linzaixing/joystick-mouse/BOM.md

# Arcade Mouse —— 物料清单（BOM）

街机摇杆 → BLE 无线鼠标（ESP32）项目的**采购 + 组装**清单。
固件已完成编译、烧录并**实测可被电脑蓝牙发现、配对成功**（2026-10-19）。

- 主控实测型号：**ESP32-C3 Super Mini**（`ESP32-C3 (QFN32) rev v0.4`，4 MB 片内 flash，MAC `f0:9e:9e:ad:77:80`）
- 引脚表、接线细节、内部上拉说明见 [README.md](README.md) 与 `joystick_mouse/joystick_mouse.ino` 头部注释
- 参考价为国内电商**粗略区间**，仅供估算，不作采购依据

---

## 1. 核心电控（必需）

| # | 物料 | 规格 / 选型要点 | 数量 | 状态 | 参考价(元) | 备注 |
|---|---|---|---|---|---|---|
| 1 | ESP32-C3 Super Mini | 乐鑫原生 USB，4 MB flash，22.5×18 mm | 1 | ✅ 已有 | 8~15 | 本项目已实测型号；用 `CDCOnBoot=cdc` 编译 |
| 1b | （替代）ESP32-WROOM-32 DevKit | 经典 ESP32，需 USB 转串口（CH340/CP2102） | 1 | 备用 | 15~25 | 引脚用固件里「第一套表」，无需 `cdc` 参数 |
| 2 | USB-C 数据线 | **要能传数据**，不是只有充电功能的线 | 1 | 待确认 | 5~10 | 烧录 + 供电 + 串口调试都靠它 |
| 3 | 排针 / 排母 | 2.54 mm，单排 | 1 条 | 待购 | 1~3 | Super Mini **出厂不带焊好的排针**，需自己焊，或直接焊导线 |
| 4 | 电源开关（可选） | 微型拨动开关 SS12D00 | 1 | 可选 | 1~2 | 装电池时建议加 |

> ⚠️ `ESP32-S2`、`ESP32-P4` 没有 BLE，不能用。

## 2. 操作件（摇杆 / 按钮 / 滚轮）

| # | 物料 | 规格 / 选型要点 | 数量 | 状态 | 参考价(元) | 备注 |
|---|---|---|---|---|---|---|
| 5 | 街机摇杆 | **微动开关式**（4 个方向微动，数字通断），8 向；常见三和 JLF-TP-8YT 或国产宝联 | 1 | 待购 | 15~40 | ⚠️ **别买电位器式 / 霍尔式**，固件是数字消抖，模拟量读不了 |
| 6 | 街机按钮 | 卡扣式 Ø24 / Ø30（如 OBSF-30 规格），自复位 | 2 | 待购 | 3~10 / 个 | 分别做左键 / 右键 |
| 7 | 滚轮模块 | **优先从废旧 2.4G 无线鼠标上拆**（编码器 + 中键微动一体） | 1 | 待购/待拆 | 0（拆机） | 拆机最省事，还自带支架与滚轮皮带 |
| 7b | （替代）机械式旋转编码器 | EC11 系列，**要带中键**（5 脚：A / B / C + 2 个按键脚） | 1 | 可选 | 3~8 | 编码器本体不贵，但要自己做滚轮与支架 |
| 8 | 精确模式按钮（可选） | 12 mm / 16 mm 自复位按钮 | 1 | 可选 | 1~3 | 按住光标降速到 35%；做机械臂时会更好用 |

## 3. 结构件与外壳

| # | 物料 | 规格 / 选型要点 | 数量 | 状态 | 参考价(元) | 备注 |
|---|---|---|---|---|---|---|
| 9 | 面板 | 亚克力 / 木板 / PVC，厚 **3~5 mm** | 1 | 待购/自制 | 10~30 | 开孔：摇杆 Ø30、按钮 Ø24/Ø30、滚轮 Ø7 |
| 10 | 底板 | 同上材质 | 1 | 待购/自制 | — | 与面板用铜柱撑开固定 |
| 11 | 螺丝 / 铜柱 | M3、M4 套装 + 自攻螺丝 | 1 套 | 待购 | 10~20 | 摇杆背面 M4 固定；卡片式按钮用卡扣环 |
| 12 | 防滑垫 | 自粘硅胶垫 | 4 | 待购 | 3~8 | 贴底板四角 |
| 13 | 摇杆防尘罩 / 球头 | 可选装饰件 | 1 | 可选 | 5~15 | 手感与外观 |

## 4. 线材与耗材

| # | 物料 | 规格 / 选型要点 | 数量 | 状态 | 参考价(元) | 备注 |
|---|---|---|---|---|---|---|
| 14 | 杜邦线 | 母-母 20 cm，或母-公 | 40 pin | 待购 | 3~6 | 摇杆自带 5 pin 排线，其余可自己接 |
| 15 | 插簧端子 | **2.8 mm** 插簧 + 绝缘护套 | 若干 | 待购 | 5~10 | 按钮/摇杆微动是 2.8 mm 端子；也可直接焊 |
| 16 | 单芯细线 / 硅胶线 | AWG26~28，多色 | 1 卷 | 待购 | 5~10 | 所有开关的 GND 汇成一条主线 |
| 17 | 热缩管 / 尼龙扎带 / 热熔胶 | — | 各 1 | 待购 | ~10 | 走线固定、绝缘收尾 |

## 5. 工具（一次性投入，非消耗件）

| # | 工具 | 用途 | 状态 | 参考价(元) |
|---|---|---|---|---|
| 18 | 电烙铁 + 焊锡 + 助焊剂 | 焊排针、焊端子/导线 | 待确认 | 50~150 |
| 19 | 万用表 | **上电前量滚轮/摇杆信号脚静态电平，必须 ≤ 3.3 V** | 待确认 | 30~80 |
| 20 | 开孔器 / 钻头 | 面板开孔（Ø30 / Ø24 / Ø7） | 待确认 | 20~40 |
| 21 | 斜口钳 / 剥线钳 / 螺丝刀 | 装线装配 | 待确认 | 20~40 |
| 22 | 带蓝牙的电脑 | 配对 + 调试（Windows / macOS / Linux / Android / iOS 均可） | ✅ 已有 | — |

## 6. 可选：无线便携供电

不做便携就**直接用 USB-C 供电/充电**，最省事，下列全部可跳过。

| # | 物料 | 规格 / 选型要点 | 数量 | 参考价(元) | 备注 |
|---|---|---|---|---|---|
| 23 | 锂电池 | 3.7 V 锂聚合物 500~1000 mAh | 1 | 15~30 | — |
| 24 | 升压模块 | MT3608 或同类，3.7 V → 5 V | 1 | 5~10 | ⚠️ 电池**不能直接接 Super Mini 的 5V 脚**（3.7 V 低于 LDO 压差要求），必须升到 5 V 再进 5V |
| 25 | 充电板 | TP4056（带保护） | 1 | 3~8 | 也可换成「充电宝 + USB-C 线」，更简单但体积大 |
| 26 | 电池盒 / 电池固定座 | 与所选电池匹配 | 1 | 3~8 | 避免电池在盒内晃动 |

> C3 Super Mini 板载 3.3 V LDO 由 5V 输入供电；**不要把锂电池直接怼到 3V3 脚**（那是 LDO 输出端）。

---

## 7. 接线对照表（按固件当前引脚，可直接照接）

所有开关一律 **COM → GND，信号脚 → GPIO**，用芯片内部上拉，**免外接电阻**。

**方案 A：ESP32-C3 Super Mini**（已烧录的这套）

| 功能 | GPIO | 对应物料 |
|---|---|---|
| 摇杆 上 UP | 3 | #5 |
| 摇杆 下 DOWN | 4 | #5 |
| 摇杆 左 LEFT | 5 | #5 |
| 摇杆 右 RIGHT | 6 | #5 |
| 按钮 左键 | 7 | #6 |
| 按钮 右键 | 10 | #6 |
| 滚轮 编码器 A 相 | 20 | #7 / #7b |
| 滚轮 编码器 B 相 | 21 | #7 / #7b |
| 滚轮 中键微动 | 0 | #7 / #7b |
| 精确模式按钮（可选） | 1 | #8 |
| 公共地 | GND | 全部 COM 脚 |

**方案 B：ESP32-WROOM-32**

| 功能 | GPIO |
|---|---|
| 摇杆 上 / 下 / 左 / 右 | 25 / 26 / 27 / 14 |
| 按钮 左键 / 右键 | 13 / 4 |
| 滚轮 编码器 A / B | 32 / 33 |
| 滚轮 中键 | 16 |
| 精确模式（可选） | 18 |

> ⚠️ C3 必须用 `--fqbn esp32:esp32:esp32c3:CDCOnBoot=cdc` 编译：编码器占的 GPIO20/21 也正是默认 UART0 的 TX/RX，不改走 USB 会抢脚（固件有 `#error` 拦）。
> ⚠️ 若你的 Super Mini 排针上**没有引出 GPIO20/21**（少数精简版只引出 0~10），告诉我，把编码器改用 GPIO2，并注意别在开机时按住对应按钮。

## 8. 采购避坑清单

1. **摇杆要微动式**——4 个独立微动、纯通断；摇杆自带 5 pin 排线但**线序各厂家不同**，上电前用万用表确认哪根是 GND。
2. **滚轮优先拆现成鼠标**——省掉编码器选型、滚轮支架、手感调校三大麻烦；买 EC11 的话注意选**带按键**的型号，且要自己解决滚轮与支架。
3. **上电前必测电平**——滚轮模块信号脚静态高点必须 ≤ 3.3 V 才可直连 GPIO；超过就加分压或电平转换。
4. **USB 线要能传数据**——劣质充电线会导致「识别不到串口 / 烧录失败」。
5. **面板开孔先想清楚厚度**——卡扣式按钮在 >5 mm 厚面板上卡不牢，换螺纹式或加卡扣环。
6. **不要用 GPIO11~17 / 18 / 19**（C3 的片内 flash 与 USB 脚）；也不要碰绑带脚 **2 / 8 / 9**。
7. **C3 Super Mini 出厂通常不焊排针**——先焊排针或直接焊线，否则接不上杜邦线。

---

## 9. 采购清单速查（可勾选）

- [ ] ESP32-C3 Super Mini（或 WROOM-32 DevKit）——**已有**
- [ ] USB-C 数据线
- [ ] 2.54 mm 排针/排母
- [ ] 微动式街机摇杆 ×1
- [ ] 卡扣式街机按钮 ×2（左/右键）
- [ ] 滚轮模块（拆旧鼠标）或 EC11 编码器（带按键）×1
- [ ] 12 mm 自复位按钮 ×1（精确模式，可选）
- [ ] 面板 + 底板（3~5 mm）
- [ ] 2.8 mm 插簧端子 + 护套
- [ ] 杜邦线 / 单芯线 / 热缩管 / 扎带
- [ ] M3/M4 螺丝铜柱 + 防滑垫
- [ ] （可选）锂电池 + MT3608 升压 + TP4056 充电板 + 电源开关
- [ ] 工具：烙铁、万用表、开孔器、剥线钳

**核心件合计（不含工具与可选供电）：约 50~110 元。**
