linzaixing/joystick-mouse/3d_files/装配体1 - 外壳-2.STL

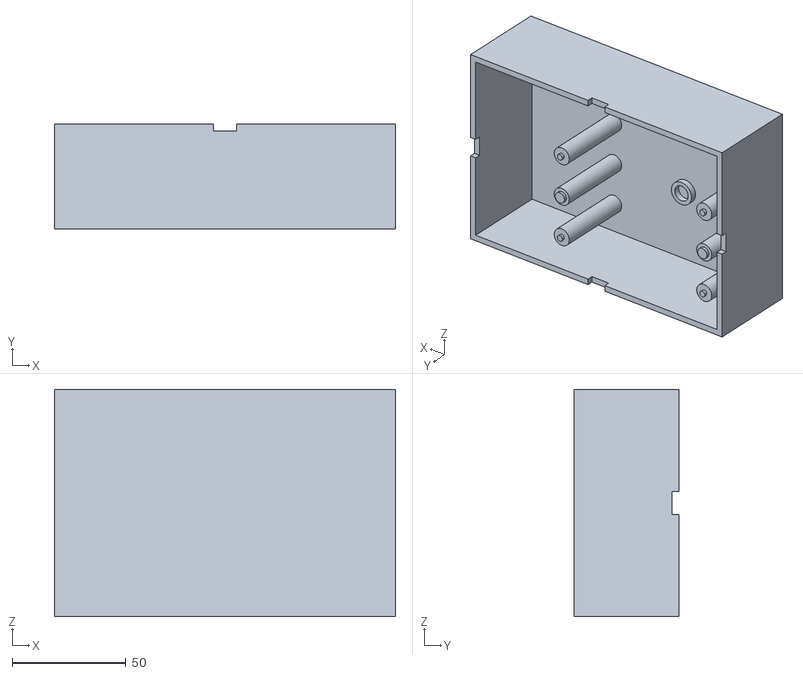
[picture p1: CAD file, 2026-11-10]
3d_files/装配体1 - 外壳-2.STL
150.0 x 46.0 x 100.0
