linzaixing/joystick-mouse/3d_files/装配体1 - 顶盖-1.STL

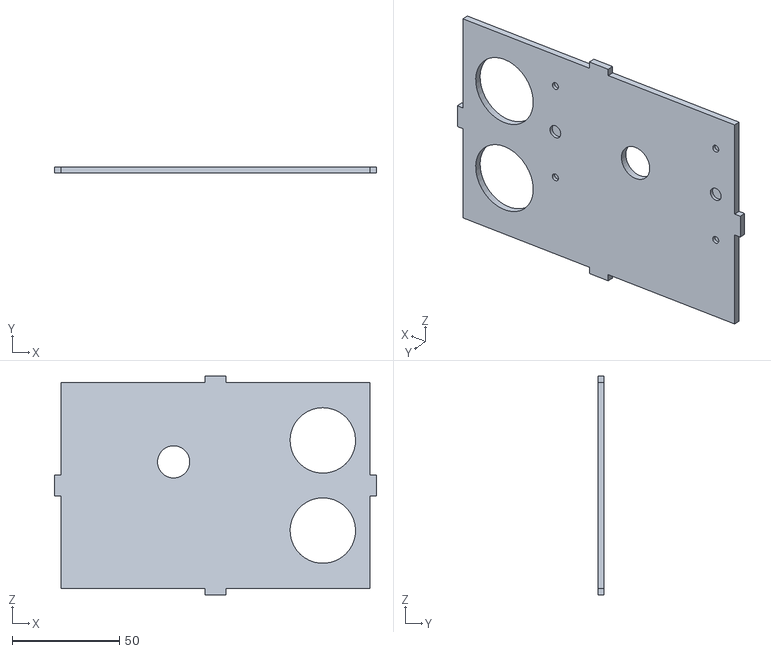
[picture p2: CAD file, 2026-11-10]
3d_files/装配体1 - 顶盖-1.STL
150.0 x 3.00 x 102.0
