linzaixing/joystick-mouse/(list of files, cad)

Other CAD files:
3d_files/外壳.SLDPRT
3d_files/顶盖.SLDPRT
3d_files/外壳.STL
