linzaixing/joystick-mouse/(commit log)

2026-10-18 feat: 街机摇杆 BLE 无线鼠标固件（ESP32 + HijelHID_BLEMouse）
    - 摇杆 4 向数字输入 + 速度斜坡（2→22 px/report，700ms 到顶速，斜向 ×0.7071）
    - 左键 / 右键街机按钮，滚轮模块复用普通鼠标的编码器 + 中键微动
    - 编码器四倍频格雷码解码（中断 + 状态机），软件消抖 6ms
    - 默认按机械式编码器接线，光学式备选接法已写入文件头注释
    - 125Hz 报告率，断连自动释放按键防粘键
2026-11-10 feat: 适配 ESP32-C3 Super Mini，并重做光标手感曲线
    C3 Super Mini 已成为实际装机的主控，原固件只覆盖 S3 与经典 ESP32，且编码器落在
    GPIO20/21 时会与默认 UART0 抢脚。新增第三套引脚表，并在编译期用 #error 拦截
    未选 CDCOnBoot=cdc 的编译，避免滚轮读数变乱这种难反推的现象。
    手感方面，摇杆是纯数字量、没有「推多深」这一维，唯一可控量是按住时长。改为
    切入补步 + 低速巡航 + t^2 二次加速的三段曲线，让轻点能停准、长按能穿屏。
    同时把 BLE 报告节拍从 125Hz 降到 50Hz，并与 SEND_MS 对齐 —— 原来发得比主机
    协商的间隔更快，主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
    [外壳.SLDPRT, 外壳.STL, 装配体1 - 外壳-2.STL, 装配体1 - 顶盖-1.STL, 顶盖.SLDPRT]
2026-11-10 chore: 忽略 SolidWorks 临时锁文件
